Antony-X/3d-keybaord/stl/switch_cube_30mm_hole14.1.stl

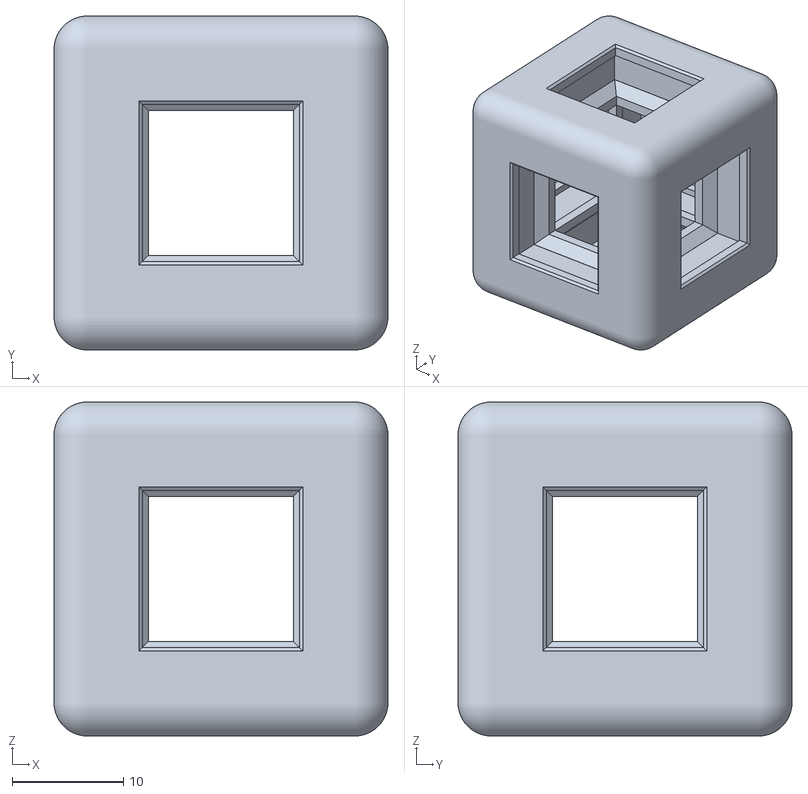
[picture p9: CAD file, 2026-10-19]
stl/switch_cube_30mm_hole14.1.stl
30.0 x 30.0 x 30.0
