Antony-X/3d-keybaord/stl/click_plate.stl

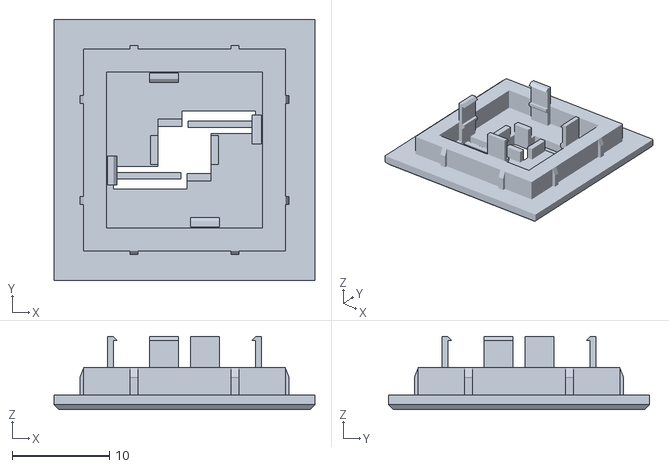
[picture p10: CAD file, 2026-10-19]
stl/click_plate.stl
26.8 x 26.8 x 7.50
