Antony-X/3d-keybaord/stl/click_plunger.stl

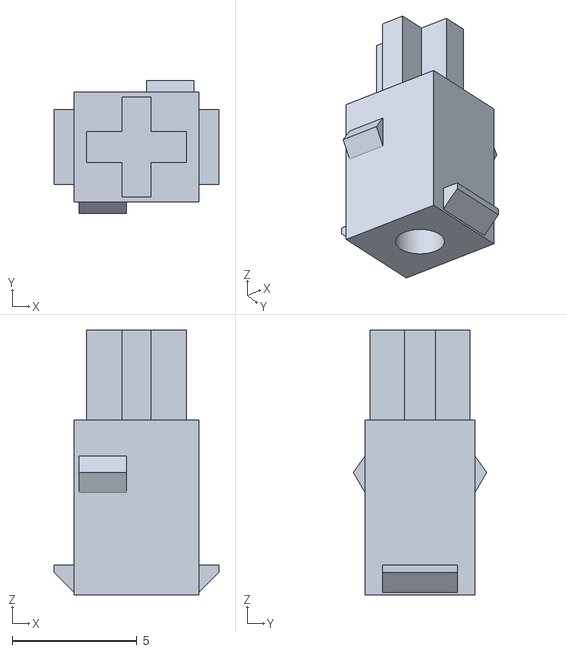
[picture p11: CAD file, 2026-10-19]
stl/click_plunger.stl
6.60 x 5.34 x 10.6
