Antony-X/3d-keybaord/stl/click_spring_light.stl

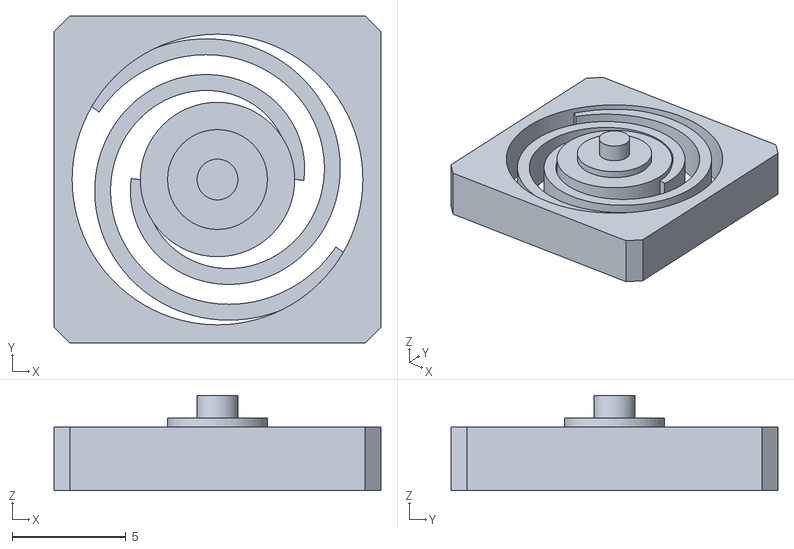
[picture p12: CAD file, 2026-10-19]
stl/click_spring_light.stl
14.4 x 14.4 x 4.20
