Antony-X/3d-keybaord/stl/click_spring.stl

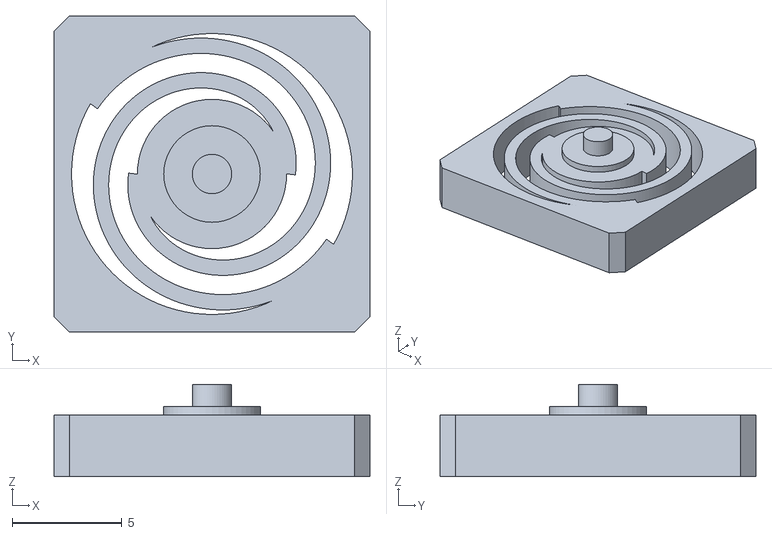
[picture p13: CAD file, 2026-10-19]
stl/click_spring.stl
14.4 x 14.4 x 4.20
