Antony-X/3d-keybaord/stl/switch_cube_30mm_hole13.9.stl

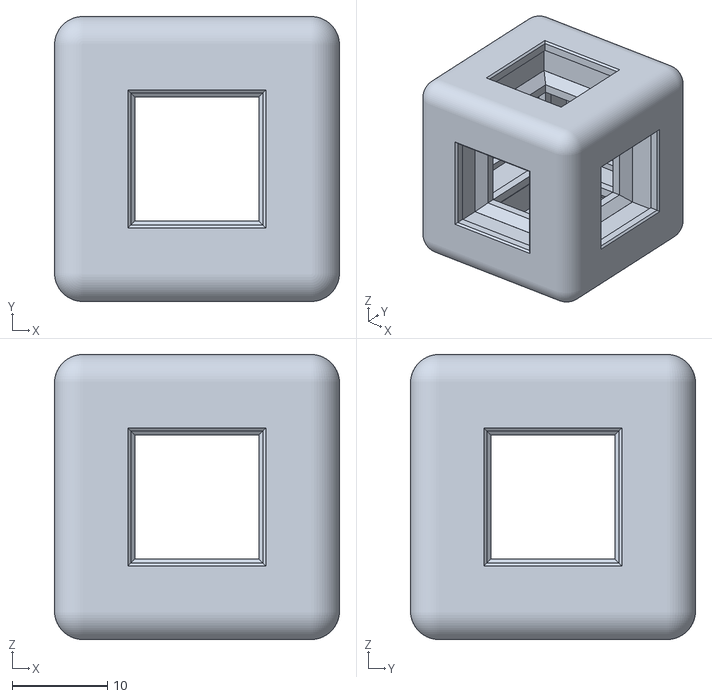
[picture p14: CAD file, 2026-10-19]
stl/switch_cube_30mm_hole13.9.stl
30.0 x 30.0 x 30.0
