Antony-X/3d-keybaord/stl/keycap_dsa_fit0.3.stl

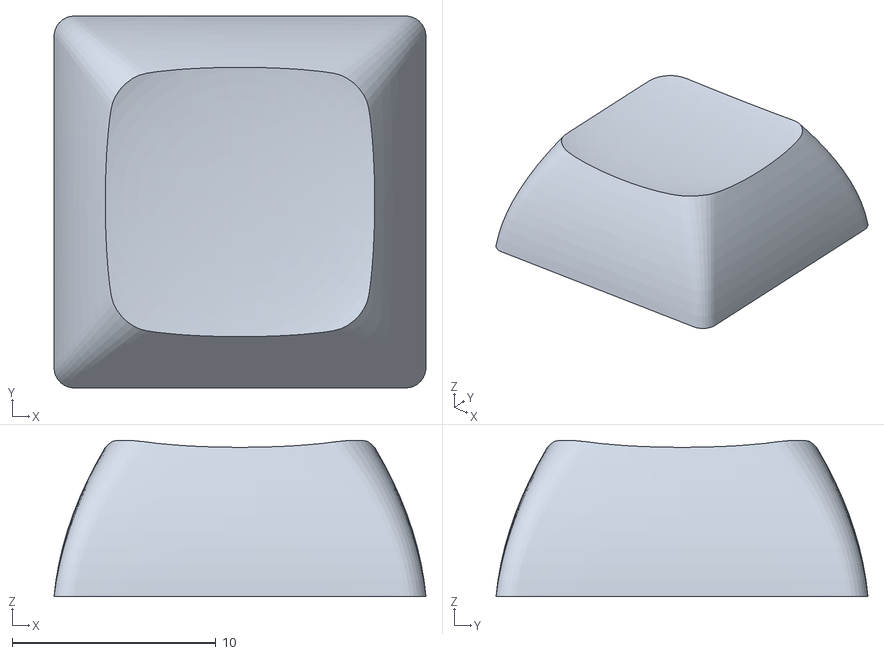
[picture p15: CAD file, 2026-10-19]
stl/keycap_dsa_fit0.3.stl
18.2 x 18.2 x 7.67
