Antony-X/3d-keybaord/stl/frame_cube_frame.stl

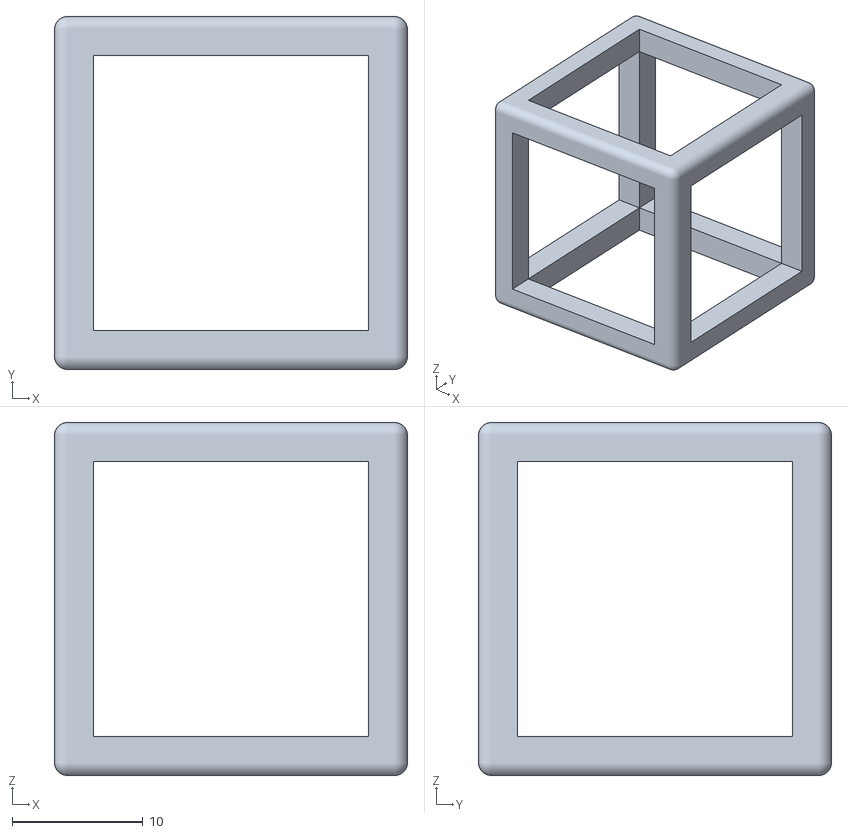
[picture p16: CAD file, 2026-10-19]
stl/frame_cube_frame.stl
27.0 x 27.0 x 27.0
