Antony-X/3d-keybaord/stl/frame_cube_plate_hole14.0.stl

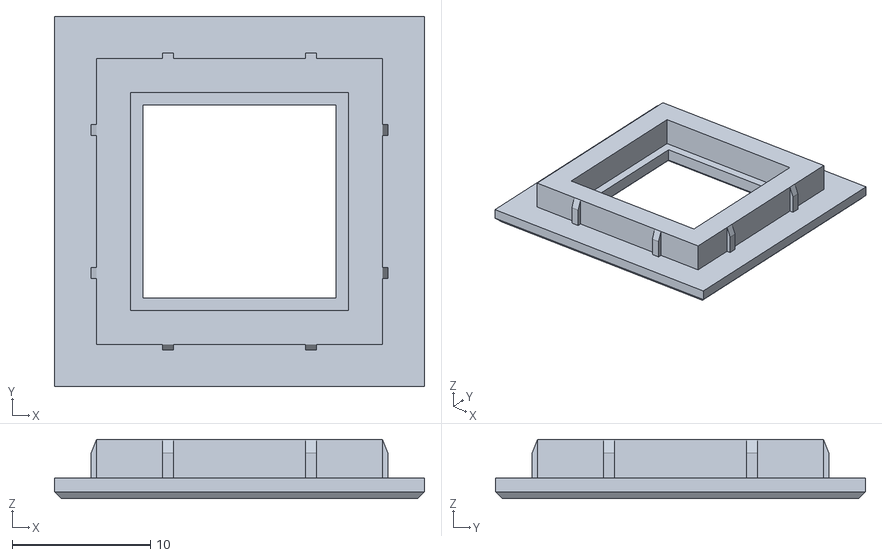
[picture p17: CAD file, 2026-10-19]
stl/frame_cube_plate_hole14.0.stl
26.8 x 26.8 x 4.30
