Antony-X/3d-keybaord/stl/switch_fit_test.stl

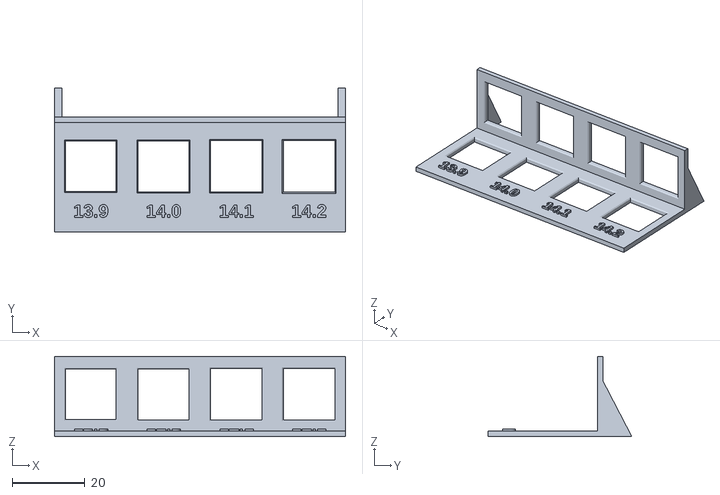
[picture p18: CAD file, 2026-10-19]
stl/switch_fit_test.stl
80.0 x 39.5 x 22.0
