Antony-X/3d-keybaord/(list of files, cad)

Other CAD files:
stl/switch_cube_30mm_hole14.2.stl
stl/switch_cube_30mm_hole14.0.stl
stl/click_plate_soft.stl
stl/keycap_dsa_fit0.2.stl
stl/keycap_dsa_fit0.1.stl
stl/keycap_dsa_fit0.4.stl
stl/frame_cube_plate_hole13.9.stl
stl/frame_cube_plate_hole14.2.stl
stl/frame_cube_plate_hole14.1.stl
