Antony-X/3d-keybaord/images/fit_test.png

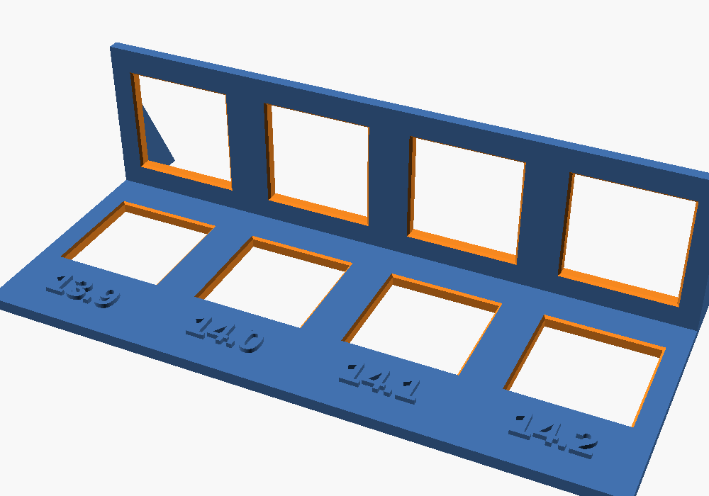
images/fit_test.png
