Antony-X/3d-keybaord/(commit log)

2026-10-19 Add printable keyboard-switch fidget cube
    One-piece 30 mm cube holding six MX-style switches, printable without
    supports. Includes parametric OpenSCAD source, STLs in four hole sizes,
    a switch fit-test piece, a collision checker that tests every switch
    rotation, preview images, and a README with parts list, print settings
    and assembly steps.
    Claude-Session: https://claude.ai/code/session_01KxPFLz9fd1Y3GY1QCGXPz1
    [preview.scad, switch_cube.scad, switch_cube_30mm_hole13.9.stl, switch_cube_30mm_hole14.0.stl, switch_cube_30mm_hole14.1.stl, switch_cube_30mm_hole14.2.stl, switch_fit_test.stl]
2026-10-19 Add frame + face-plate version of the cube
    Skeleton frame plus six identical press-fit face plates, matching the
    original cube's construction. All parts print flat without supports;
    crush ribs on each plate's locating ring give a forgiving press fit.
    The assembled version passes the same switch collision check.
    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
    [frame_cube.scad, frame_cube_frame.stl, frame_cube_plate_hole13.9.stl, frame_cube_plate_hole14.0.stl, frame_cube_plate_hole14.1.stl, frame_cube_plate_hole14.2.stl, preview.scad, switch_cube_30mm_hole13.9.stl]
2026-10-19 Add printable keycaps and printed-switch research
    Generate DSA keycaps with KeyV2 (added as a submodule) at four stem
    tolerances so the stem fit can be tuned per printer. Previews now show
    the printed keycaps. Switch to a recent OpenSCAD for the build (KeyV2
    needs it; output geometry is unchanged) and binary STLs. README covers
    keycap printing and why switches are still bought, with the printed
    switch designs that exist and how well tested they are.
    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
    [frame_cube_frame.stl, frame_cube_plate_hole13.9.stl, frame_cube_plate_hole14.0.stl, frame_cube_plate_hole14.1.stl, frame_cube_plate_hole14.2.stl, keycap.scad, keycap_dsa_stem0.2.stl, keycap_dsa_stem0.3.stl]
2026-10-19 Fix keycap fit variants to change the cross hole
    KeyV2's $stem_slop only resizes the outside of the keycap stem; the fit
    on the switch's + stem is $stem_inner_slop. Generate the four test caps
    with different cross-hole clearances (0.1-0.4 mm) instead, setting the
    value in a local scope so KeyV2's settings don't override it.
    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
    [keycap.scad, keycap_dsa_fit0.1.stl, keycap_dsa_fit0.2.stl, keycap_dsa_fit0.3.stl, keycap_dsa_fit0.4.stl, keycap_dsa_stem0.2.stl, keycap_dsa_stem0.3.stl, keycap_dsa_stem0.4.stl]
2026-10-19 Add experimental fully printed click module
    A printed replacement for plate + switch in the frame version: a face
    plate with two flexible click fins, a plunger with an MX cross stem and
    teeth that snap past the fins, and a flat two-arm PETG spiral spring.
    No glue or metal; the keycap landing on the plate is the bottom stop.
    check_click.py verifies the plunger only touches the fins over the
    stroke, that six modules never collide with each other or the frame in
    any rotation, and that the spring always overcomes the fins on the
    return stroke (friction 0.25-0.4). spring_fe.py is a beam model used to
    size the spring to the strain level of a proven printed PETG spring.
    README documents printing,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
    [click_module.scad, click_plate.stl, click_plate_soft.stl, click_plunger.stl, click_spring.stl, click_spring_light.stl, preview.scad, switch_cube_30mm_hole13.9.stl]
